hhaudio/ClassD_Amplifier_Daughter/ClassDAmp_Schematic.pdf

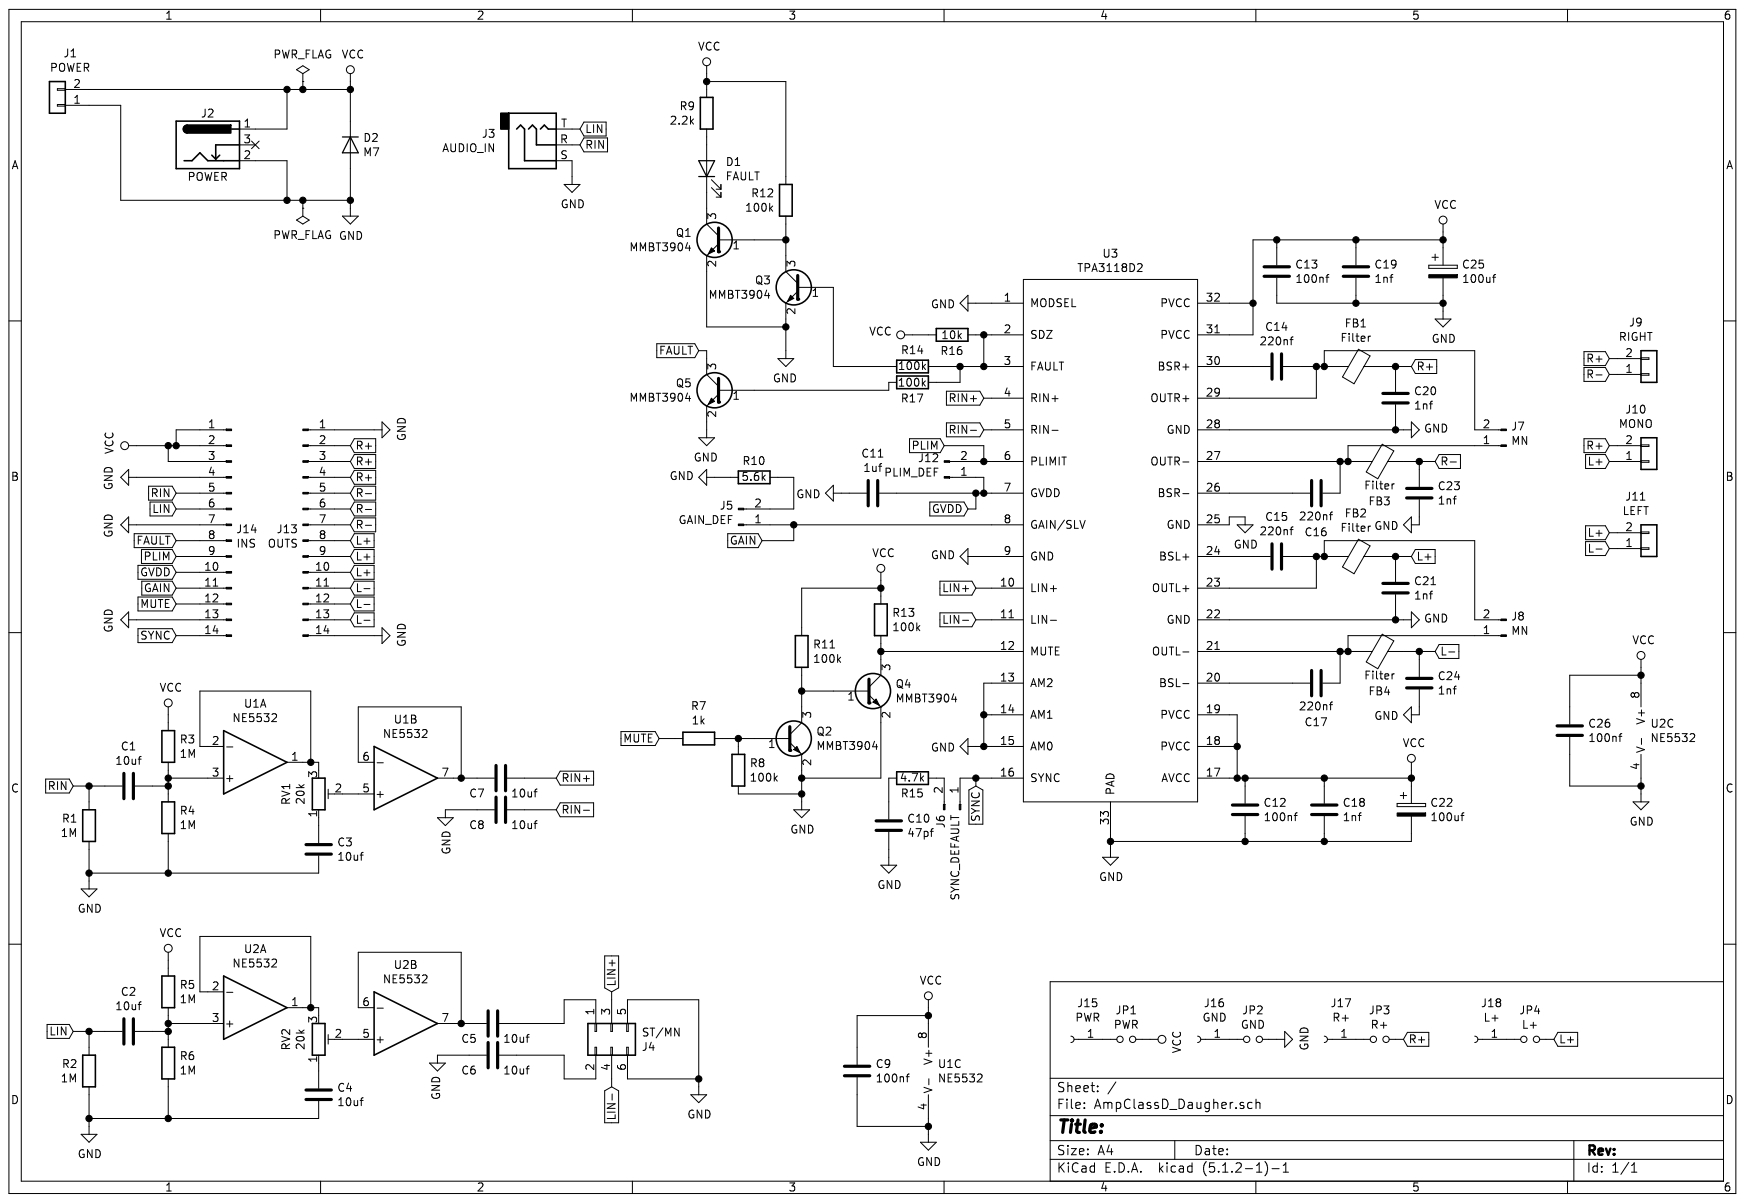
[picture p1: page 1]
