hhaudio/ClassD_Amplifier_Daughter/AmpClassD_Daugher.kicad_pcb

## KiCad design AmpClassD_Daugher.kicad_pcb (2023-05-29)

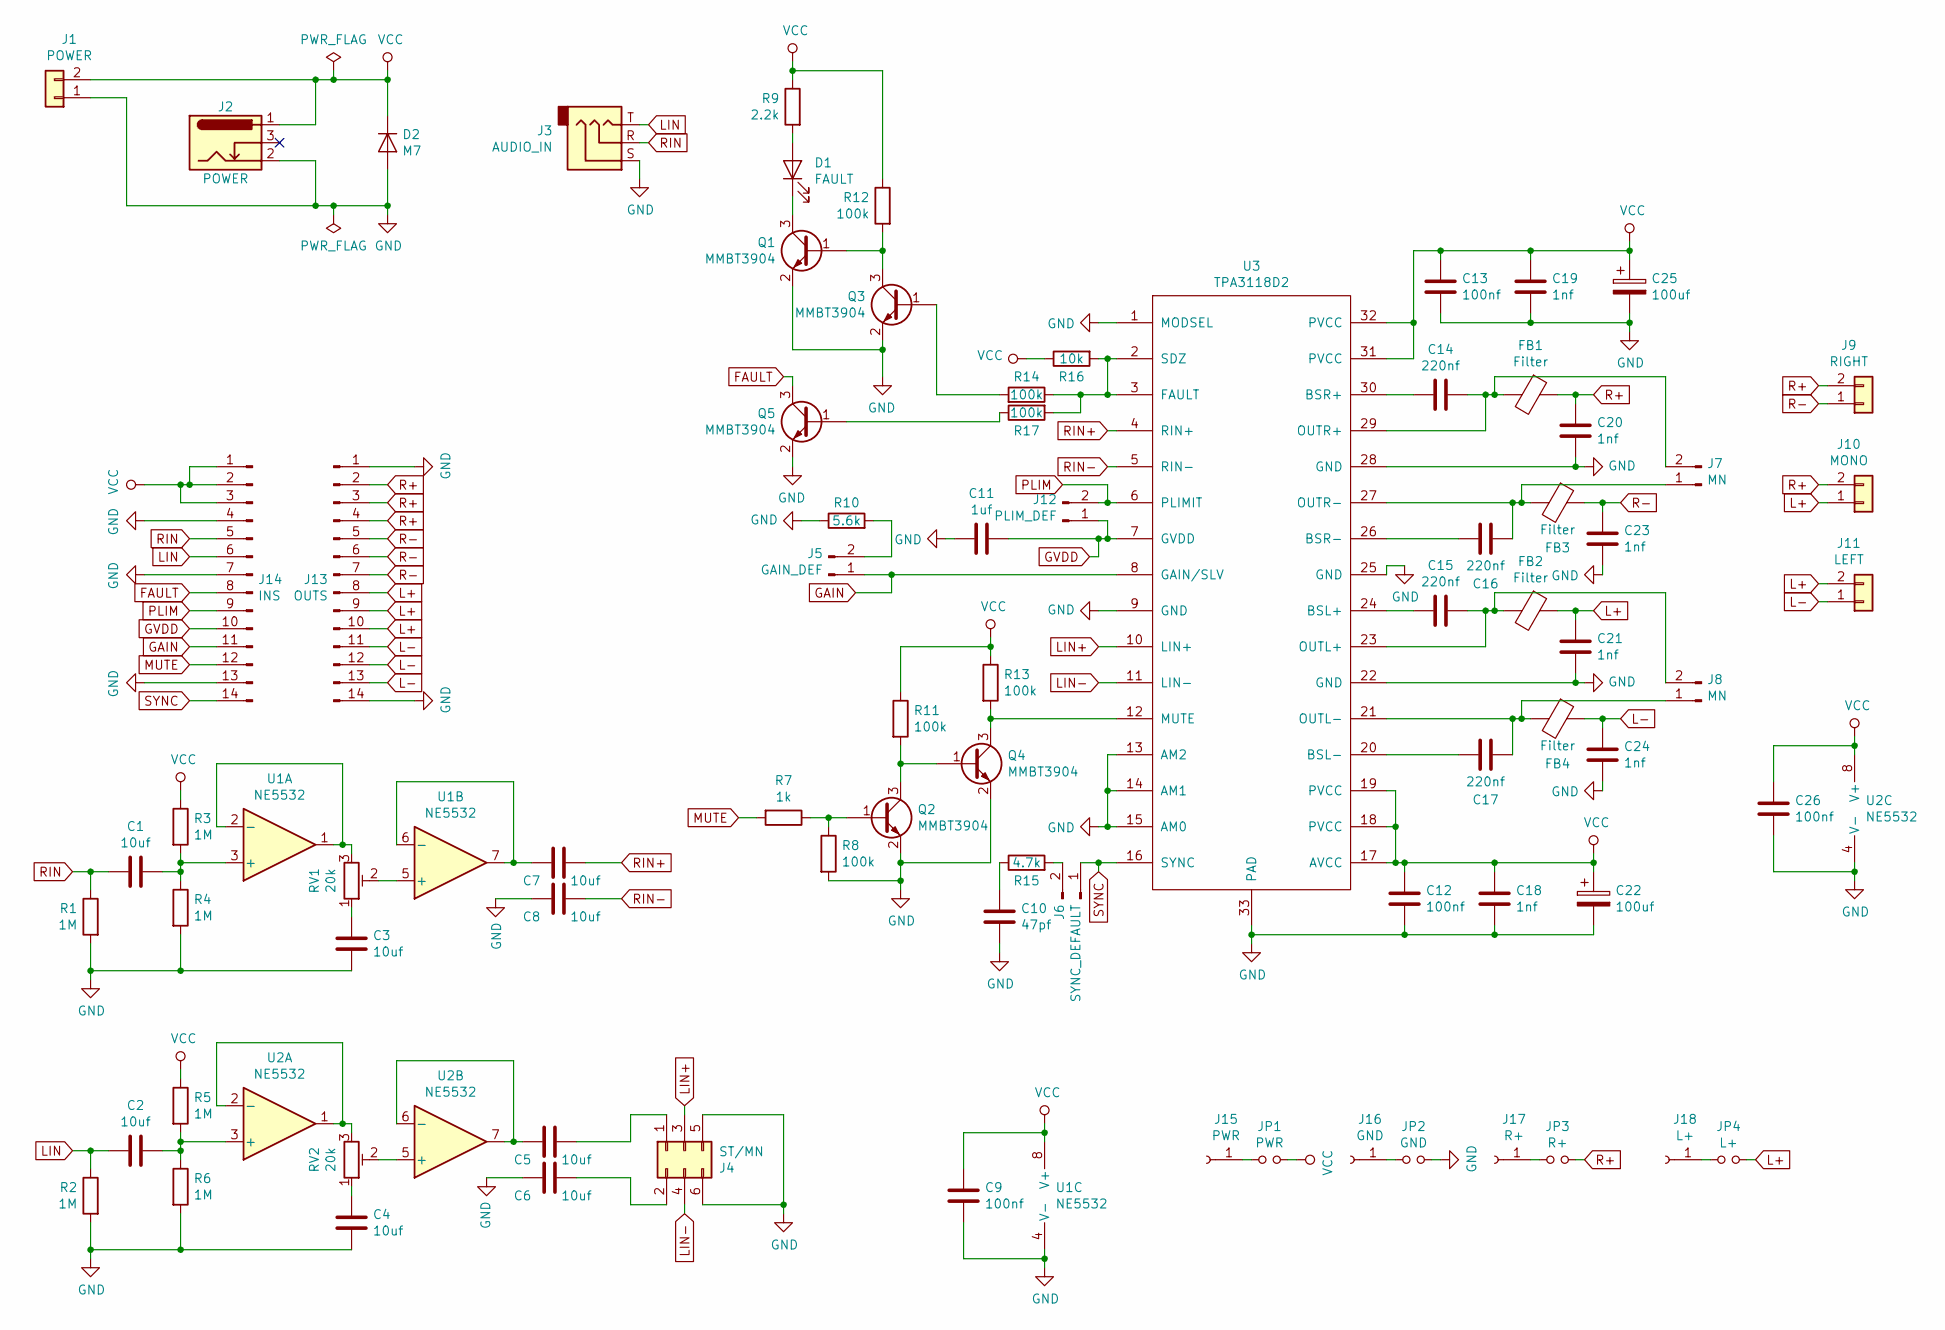
[picture p2: schematic AmpClassD_Daugher.sch]

Parts:
C1, C2, C3, C4, C5, C6, C7, C8: 10uf; C_0603_1608Metric_Pad1.05x0.95mm_HandSolder_SmallRef
C9, C12, C13, C26: 100nf; C_0603_1608Metric_Pad1.05x0.95mm_HandSolder_SmallRef
C10: 47pf; C_0603_1608Metric_Pad1.05x0.95mm_HandSolder_SmallRef
C11: 1uf; C_0603_1608Metric_Pad1.05x0.95mm_HandSolder_SmallRef
C14, C15, C16, C17: 220nf; C_0603_1608Metric_Pad1.05x0.95mm_HandSolder_SmallRef
C18, C19, C20, C21, C23, C24: 1nf; C_0603_1608Metric_Pad1.05x0.95mm_HandSolder_SmallRef
C22, C25: 100uf; CP_Elec_6.3x7.7
D1: FAULT; LED_0805_2012Metric_Pad1.15x1.40mm_HandSolder
D2: M7; D_SMA
FB1, FB2, FB3, FB4: Filter; L_1206_3216Metric_Pad1.42x1.75mm_HandSolder
J1: POWER; Phoenix_Stacked_Marking2_Wider_NoRef_Centered
J2: POWER; SMD_DC_Barrel_JLC
J3: AUDIO_IN; 3.5mm_JLC_PJ-321A-4A_TRS_Silk
J4: ST/MN; PinHeader_2x03_P2.54mm_Vertical_SMD
J5: GAIN_DEF; PinHeader_1x02_P2.54mm_Vertical_SMD_Pin1Right
J6: SYNC_DEFAULT; PinHeader_1x02_P2.54mm_Vertical_SMD_Pin1Right
J7, J8: MN; PinHeader_1x02_P2.54mm_Vertical_SMD_Pin1Right
J9: RIGHT; Phoenix_Stacked_Marking2_Wider_NoRef_Centered
J10: MONO; Phoenix_Stacked_Marking2_Wider_NoRef_Centered
J11: LEFT; Phoenix_Stacked_Marking2_Wider_NoRef_Centered
J12: PLIM_DEF; PinHeader_1x02_P2.54mm_Vertical_SMD_Pin1Right
J13: OUTS; PinHeader_1x14_P2.54mm_Vertical
J14: INS; PinHeader_1x14_P2.54mm_Vertical
J15: PWR; M3_Plated
J16: GND; M3_Plated
J17: R+; M3_Plated
J18: L+; M3_Plated
JP1: PWR; SolderJumper-2_P1.3mm_Open_Pad1.0x1.5mm
JP2: GND; SolderJumper-2_P1.3mm_Open_Pad1.0x1.5mm
JP3: R+; SolderJumper-2_P1.3mm_Open_Pad1.0x1.5mm
JP4: L+; SolderJumper-2_P1.3mm_Open_Pad1.0x1.5mm
Q1, Q2, Q3, Q4, Q5: MMBT3904; SOT-23
R1, R2, R3, R4, R5, R6: 1M; R_0603_1608Metric_Pad1.05x0.95mm_HandSolder_SmallRef
R7: 1k; R_0603_1608Metric_Pad1.05x0.95mm_HandSolder_SmallRef
R8, R11, R12, R13, R14, R17: 100k; R_0603_1608Metric_Pad1.05x0.95mm_HandSolder_SmallRef
R9: 2.2k; R_0603_1608Metric_Pad1.05x0.95mm_HandSolder_SmallRef
R10: 5.6k; R_0603_1608Metric_Pad1.05x0.95mm_HandSolder_SmallRef
R15: 4.7k; R_0603_1608Metric_Pad1.05x0.95mm_HandSolder_SmallRef
R16: 10k; R_0603_1608Metric_Pad1.05x0.95mm_HandSolder_SmallRef
RV1, RV2: 20k; SMD_TRIM_JLC
U1, U2: NE5532; SO-8_3.9x4.9mm_P1.27mm
U3: TPA3118D2; HTSSOP-32-1EP_6.1x11mm_P0.65mm_EP5.2x11mm_Mask4.11x4.36mm_T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

Connections:
FAULT: J14.8, Q5.3 (C)
GAIN: J5.1, J14.11, U3.8 (GAIN/SLV)
GND: C3.2, C4.2, C6.2, C8.2, C9.2, C10.2, C11.2, C12.2, C13.2, C18.2, C19.2, C20.2, C21.2, C22.2, C23.2, C24.2, C25.2, C26.2, D2.2 (A), J1.1, J2.2, J3.S, J4.5, J4.6, J13.1, J13.14, J14.4, J14.7, J14.13, JP2.2, Q1.2 (E), Q2.2 (E), Q3.2 (E), Q4.2 (E), Q5.2 (E), R1.2, R2.2, R4.2, R6.2, R8.2, R10.1, U1.4 (V-), U2.4 (V-), U3.1 (MODSEL), U3.9 (GND), U3.13 (AM2), U3.14 (AM1), U3.15 (AM0), U3.22 (GND), U3.25 (GND), U3.28 (GND), U3.33 (PAD)
GVDD: C11.1, J12.1, J14.10, U3.7 (GVDD)
L+: C21.1, FB2.1, J10.1, J11.2, J13.8, J13.9, J13.10, JP4.2
L-: C24.1, FB4.1, J11.1, J13.11, J13.12, J13.13
LIN: C2.2, J3.T, J14.6, R2.1
LIN+: J4.3, U3.10 (LIN+)
LIN-: J4.4, U3.11 (LIN-)
MUTE: J14.12, R7.2
unnamed: C1.1, R3.2, R4.1, U1.3 (+)
unnamed: C2.1, R5.2, R6.1, U2.3 (+)
unnamed: C3.1, RV1.1
unnamed: C4.1, RV2.1
unnamed: C5.1, J4.1
unnamed: C5.2, U2.6 (-), U2.7
unnamed: C6.1, J4.2
unnamed: C7.2, U1.6 (-), U1.7
unnamed: C10.1, R15.1
unnamed: C14.1, FB1.2, J7.2, U3.29 (OUTR+)
unnamed: C14.2, U3.30 (BSR+)
unnamed: C15.1, FB2.2, J8.2, U3.23 (OUTL+)
unnamed: C15.2, U3.24 (BSL+)
unnamed: C16.1, U3.26 (BSR-)
unnamed: C16.2, FB3.2, J7.1, U3.27 (OUTR-)
unnamed: C17.1, U3.20 (BSL-)
unnamed: C17.2, FB4.2, J8.1, U3.21 (OUTL-)
unnamed: D1.1 (K), Q1.3 (C)
unnamed: D1.2 (A), R9.2
unnamed: J5.2, R10.2
unnamed: J6.2, R15.2
unnamed: J15.1, JP1.1
unnamed: J16.1, JP2.1
unnamed: J17.1, JP3.1
unnamed: J18.1, JP4.1
unnamed: Q1.1 (B), Q3.3 (C), R12.2
unnamed: Q2.1 (B), R7.1, R8.1
unnamed: Q2.3 (C), Q4.1 (B), R11.2
unnamed: Q3.1 (B), R14.2
unnamed: Q4.3 (C), R13.2, U3.12 (MUTE)
unnamed: Q5.1 (B), R17.1
unnamed: R14.1, R16.2, R17.2, U3.2 (SDZ), U3.3 (FAULT)
unnamed: RV1.2, U1.5 (+)
unnamed: RV1.3, U1.1, U1.2 (-)
unnamed: RV2.2, U2.5 (+)
unnamed: RV2.3, U2.1, U2.2 (-)
PLIM: J12.2, J14.9, U3.6 (PLIMIT)
R+: C20.1, FB1.1, J9.2, J10.2, J13.2, J13.3, J13.4, JP3.2
R-: C23.1, FB3.1, J9.1, J13.5, J13.6, J13.7
RIN: C1.2, J3.R, J14.5, R1.1
RIN+: C7.1, U3.4 (RIN+)
RIN-: C8.1, U3.5 (RIN-)
SYNC: J6.1, J14.14, U3.16 (SYNC)
VCC: C9.1, C12.1, C13.1, C18.1, C19.1, C22.1, C25.1, C26.1, D2.1 (K), J1.2, J2.1, J14.1, J14.2, J14.3, JP1.2, R3.1, R5.1, R9.1, R11.1, R12.1, R13.1, R16.1, U1.8 (V+), U2.8 (V+), U3.17 (AVCC), U3.18 (PVCC), U3.19 (PVCC), U3.31 (PVCC), U3.32 (PVCC)

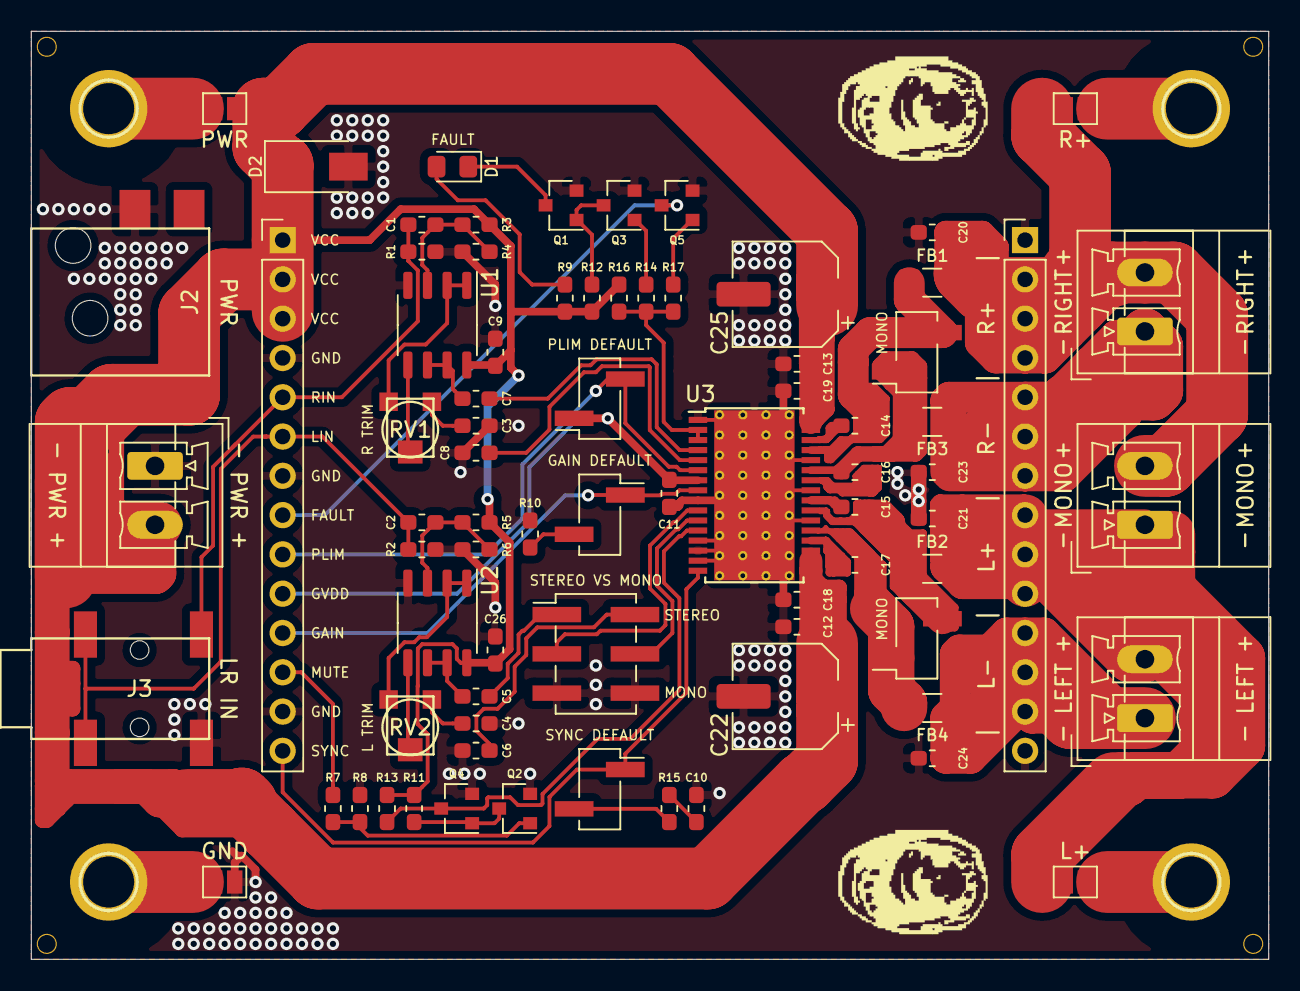
[picture p3: board AmpClassD_Daugher.kicad_pcb from above]

Board: 2 copper layers, 80.0 x 60.0 mm, 81 parts (0 on the bottom side), 54 nets.
