hhaudio/ClassD_Amplifier_Daughter/(commit log)

2022-02-13 fixed preamp circuit
    [AmpClassD_Daugher.kicad_pcb, AmpClassD_Daugher.sch]
2022-02-13 schematic updates
    [AmpClassD_Daugher.kicad_pcb, AmpClassD_Daugher.sch]
2022-02-13 layout progress
    [AmpClassD_Daugher.kicad_pcb, AmpClassD_Daugher.sch]
2022-02-14 initial layout finished
    [AmpClassD_Daugher.kicad_pcb]
